haxeko/h2-zigbee-lis2dh12/hardware/out/fab/activity-badge-bom-jlcpcb.csv

Comment | Designator | Footprint | LCSC Part # | Manufacturer Part # | Qty
10 uF 16 V X5R 0603 | C1 | 0603 |  |  | 1
10 uF 10 V X5R 0603 | C2,C5,C8 | 0603 |  |  | 3
1 uF 16 V X5R 0402 | C3 | 0402 |  |  | 1
22 uF 6.3 V X5R 0805 | C4 | 0805 |  |  | 1
100 nF 16 V X7R 0402 | C6,C7,C9,C11 | 0402 |  |  | 4
10 nF 50 V X7R 0402 | C10 | 0402 |  |  | 1
LED green 0603 | D1 | 0603 |  |  | 1
LED orange 0603 | D2 | 0603 |  |  | 1
TYPE-C-31-M-12 | J1 | USB_C_Receptacle_HRO_TYPE-C-31-M-12 |  | TYPE-C-31-M-12 | 1
AO3401A | Q1 | SOT-23 |  | AO3401A | 1
2N7002 | Q2 | SOT-23 |  | 2N7002 | 1
5.1 k 1% 0402 | R1,R2 | 0402 |  |  | 2
4.7 k 1% 0402 | R3,R5,R6 | 0402 |  |  | 3
1 k 1% 0402 | R4 | 0402 |  |  | 1
10 k 1% 0402 | R7,R8 | 0402 |  |  | 2
2.2 k 1% 0402 | R9 | 0402 |  |  | 1
1 M 1% 0402 | R10,R11 | 0402 |  |  | 2
100 k 1% 0402 | R12,R13 | 0402 |  |  | 2
0 R 0402 | R14,R15 | 0402 |  |  | 2
B3U-1000P | SW1,SW2 | SW_SPST_B3U-1000P |  | B3U-1000P | 2
ESP32-H2-WROOM-02C-H4S | U1 | ESP32-H2-WROOM-02C |  | ESP32-H2-WROOM-02C-H4S | 1
LIS2DH12TR | U2 | LGA-12 |  | LIS2DH12TR | 1
RT9080-33GJ5 | U3 | TSOT-23-5 |  | RT9080-33GJ5 | 1
MCP73831T-2ACI/OT | U4 | SOT-23-5 |  | MCP73831T-2ACI/OT | 1
USBLC6-2SC6 | U5 | SOT-23-6 |  | USBLC6-2SC6 | 1
