haxeko/h2-zigbee-lis2dh12/hardware/out/activity-badge.pdf

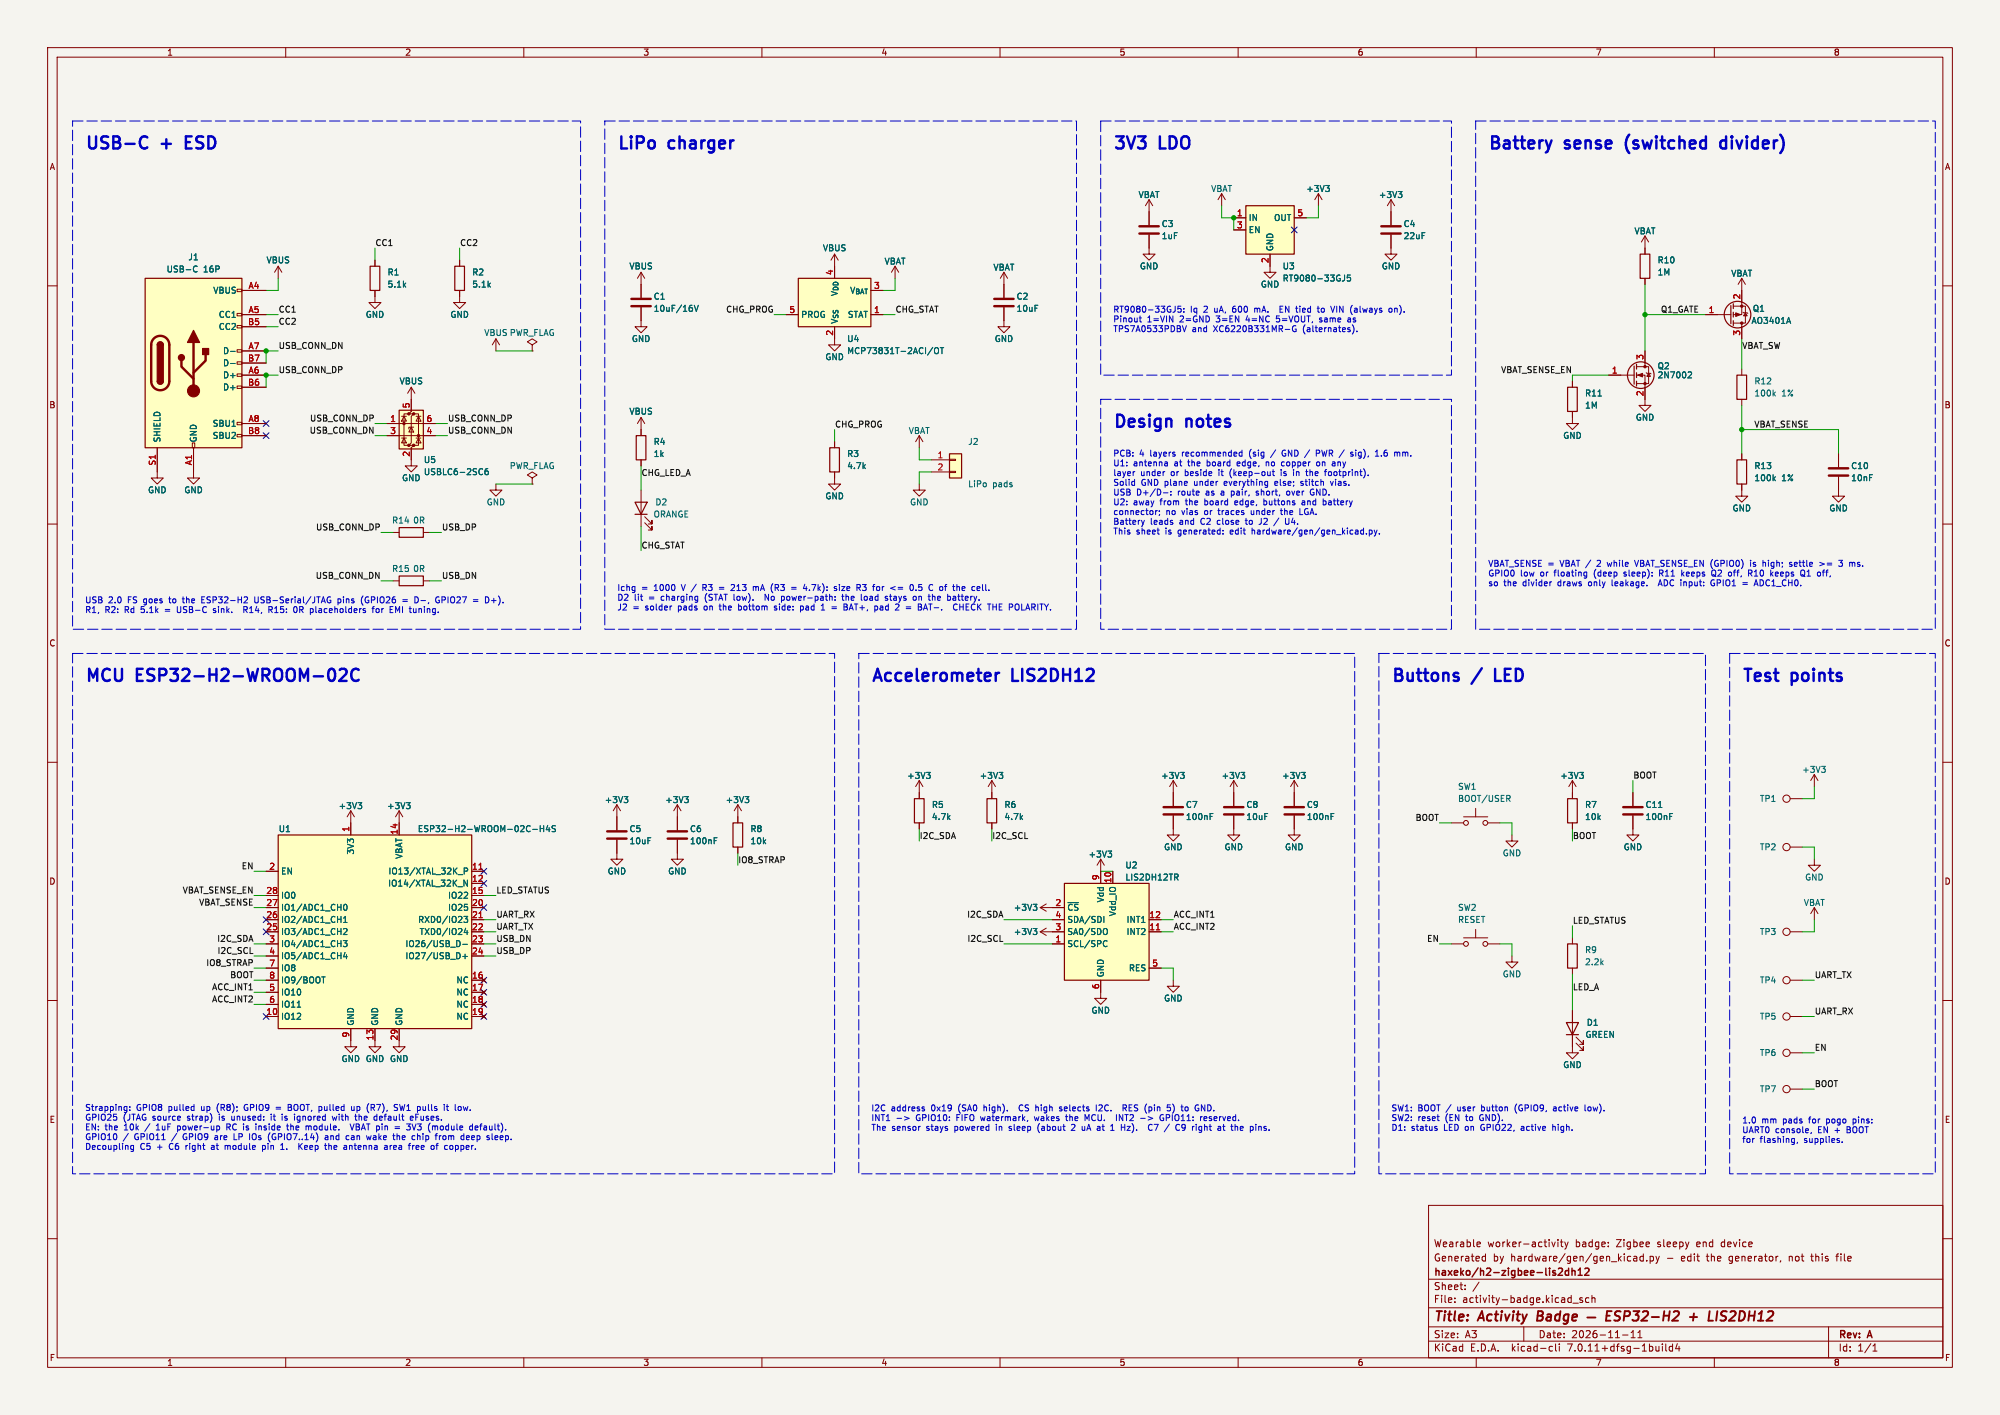
[picture p3: page 1]

VBAT VBAT GND GND

LiPo pads VBAT GND

SW1: BOOT / user button (GPIO9, active low). SW2: reset (EN to GND). D1: status LED on GPIO22, active high.
