haxeko/h2-zigbee-lis2dh12/hardware/out/pcb-back.pdf

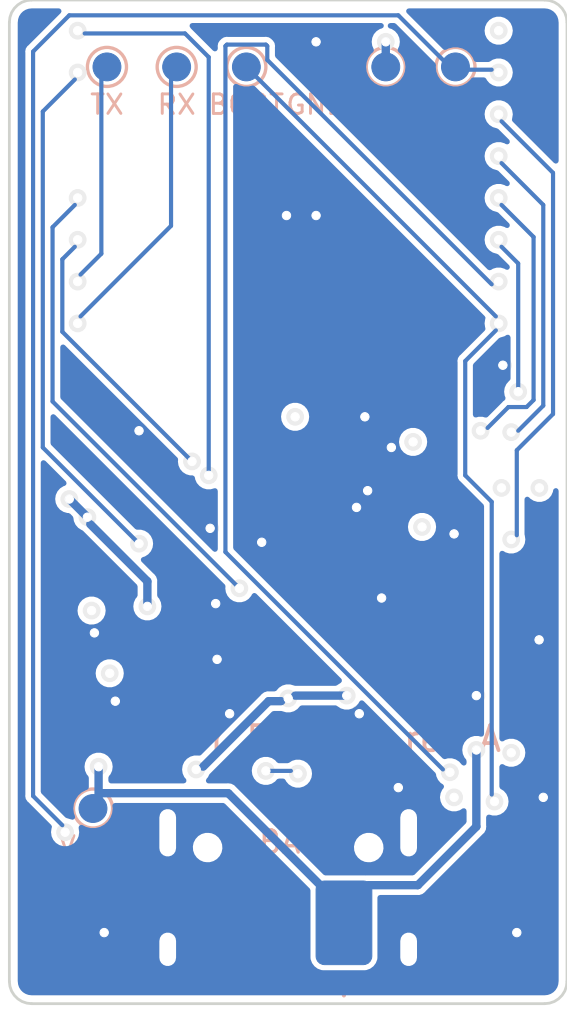
[picture p4: page 1]
