haxeko/h2-zigbee-lis2dh12/hardware/out/pcb-front.pdf

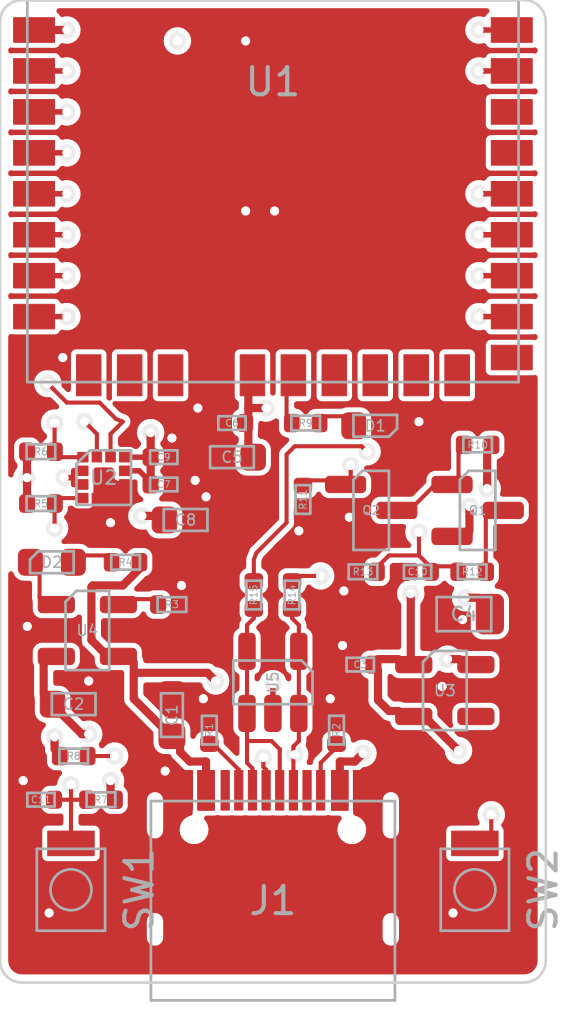
[picture p5: page 1]
