haxeko/h2-zigbee-lis2dh12/hardware/kicad/activity-badge.kicad_pcb

## KiCad design hardware/kicad/activity-badge.kicad_pcb (2026-11-11)

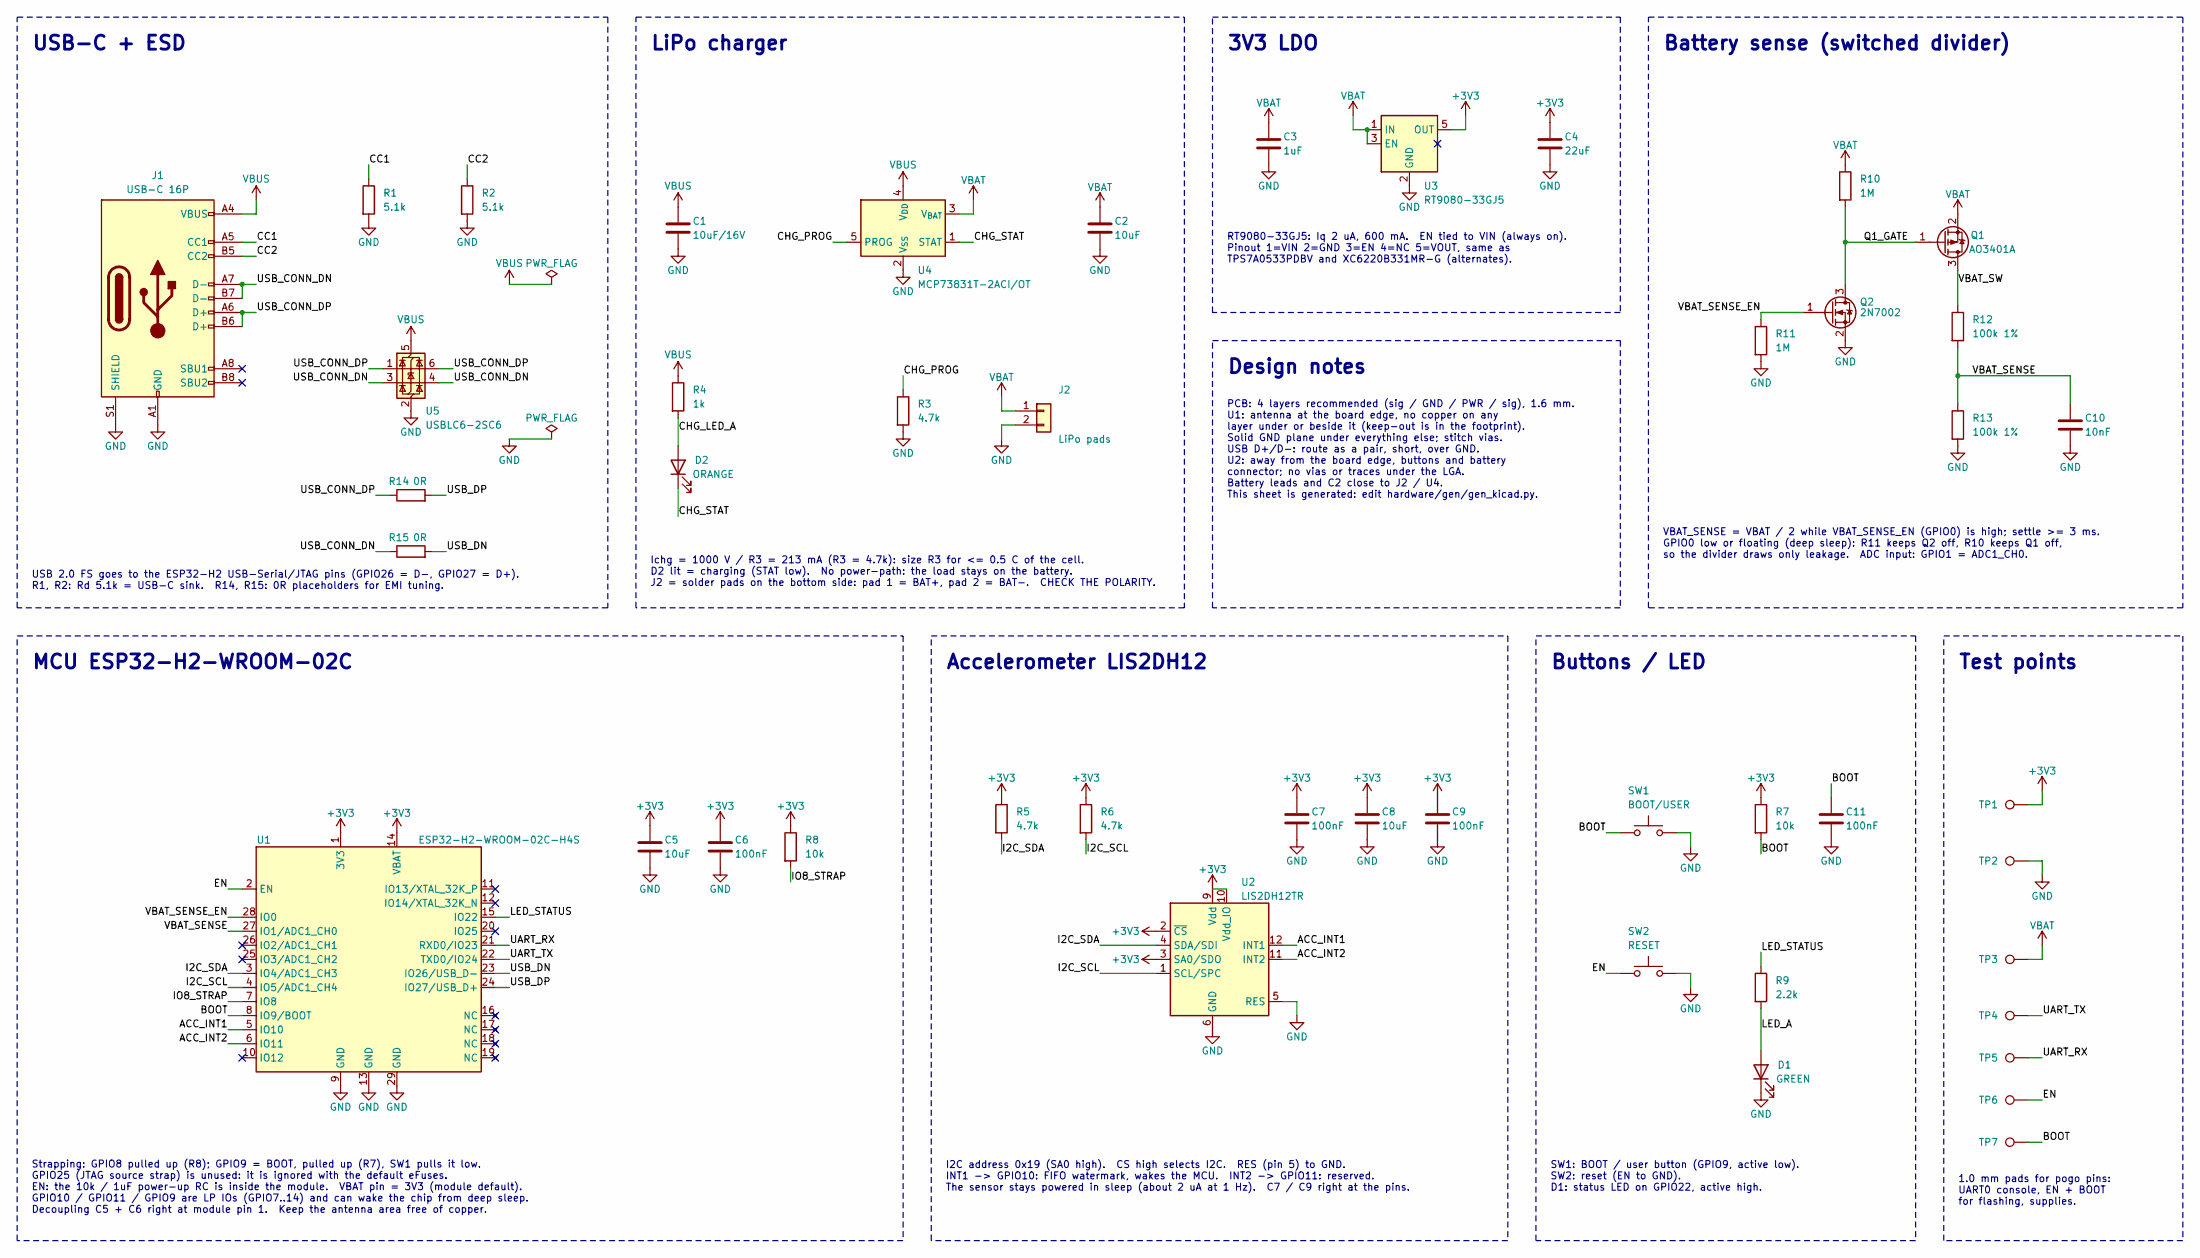
[picture p6: schematic activity-badge.kicad_sch, Activity Badge — ESP32-H2 + LIS2DH12]

Parts:
C1: 10uF/16V; C_0603_1608Metric; MPN CL10A106KO8NNNC
C2, C5, C8: 10uF; C_0603_1608Metric; MPN CL10A106KP8NNNC
C3: 1uF; C_0402_1005Metric; MPN CL05A105KO5NNNC
C4: 22uF; C_0805_2012Metric; MPN CL21A226MQQNNNE
C6, C7, C9, C11: 100nF; C_0402_1005Metric; MPN CL05B104KO5NNNC
C10: 10nF; C_0402_1005Metric; MPN CL05B103KB5NNNC
D1: GREEN; LED_0603_1608Metric; MPN LTST-C191KGKT
D2: ORANGE; LED_0603_1608Metric; MPN LTST-C191KFKT
J1: USB-C 16P; USB_C_Receptacle_HRO_TYPE-C-31-M-12; MPN TYPE-C-31-M-12
J2: LiPo pads; BatteryPads_1x02_P4.0mm
Q1: AO3401A; SOT-23; MPN AO3401A
Q2: 2N7002; SOT-23; MPN 2N7002
R1, R2: 5.1k; R_0402_1005Metric; MPN RC0402FR-075K1L
R3, R5, R6: 4.7k; R_0402_1005Metric; MPN RC0402FR-074K7L
R4: 1k; R_0402_1005Metric; MPN RC0402FR-071KL
R7, R8: 10k; R_0402_1005Metric; MPN RC0402FR-0710KL
R9: 2.2k; R_0402_1005Metric; MPN RC0402FR-072K2L
R10, R11: 1M; R_0402_1005Metric; MPN RC0402FR-071ML
R12, R13: 100k 1%; R_0402_1005Metric; MPN RC0402FR-07100KL
R14, R15: 0R; R_0402_1005Metric; MPN RC0402JR-070RL
SW1: BOOT/USER; SW_SPST_B3U-1000P; MPN B3U-1000P
SW2: RESET; SW_SPST_B3U-1000P; MPN B3U-1000P
TP1: +3V3; TestPoint_Pad_D1.0mm
TP2: GND; TestPoint_Pad_D1.0mm
TP3: VBAT; TestPoint_Pad_D1.0mm
TP4: UART_TX; TestPoint_Pad_D1.0mm
TP5: UART_RX; TestPoint_Pad_D1.0mm
TP6: EN; TestPoint_Pad_D1.0mm
TP7: BOOT; TestPoint_Pad_D1.0mm
U1: ESP32-H2-WROOM-02C-H4S; ESP32-H2-WROOM-02C; MPN ESP32-H2-WROOM-02C-H4S
U2: LIS2DH12TR; LGA-12_2x2mm_P0.5mm; MPN LIS2DH12TR
U3: RT9080-33GJ5; TSOT-23-5; MPN RT9080-33GJ5
U4: MCP73831T-2ACI/OT; SOT-23-5; MPN MCP73831T-2ACI/OT
U5: USBLC6-2SC6; SOT-23-6; MPN USBLC6-2SC6

Connections:
+3V3: C4.1, C5.1, C6.1, C7.1, C8.1, C9.1, R5.1, R6.1, R7.1, R8.1, TP1.1, U1.1 (3V3), U1.14 (VBAT), U2.2 (~CS), U2.3 (SA0/SDO), U2.9 (Vdd), U2.10 (Vdd_IO), U3.5 (OUT)
/ACC_INT1: U1.5 (IO10), U2.12 (INT1)
/ACC_INT2: U1.6 (IO11), U2.11 (INT2)
/BOOT: C11.1, R7.2, SW1.1, TP7.1, U1.8 (IO9/BOOT)
/CC1: J1.A5 (CC1), R1.1
/CC2: J1.B5 (CC2), R2.1
/CHG_LED_A: D2.2 (A), R4.2
/CHG_PROG: R3.1, U4.5 (PROG)
/CHG_STAT: D2.1 (K), U4.1 (STAT)
/EN: SW2.1, TP6.1, U1.2 (EN)
/I2C_SCL: R6.2, U1.4 (IO5/ADC1_CH4), U2.1 (SCL/SPC)
/I2C_SDA: R5.2, U1.3 (IO4/ADC1_CH3), U2.4 (SDA/SDI)
/IO8_STRAP: R8.2, U1.7 (IO8)
/LED_A: D1.2 (A), R9.2
/LED_STATUS: R9.1, U1.15 (IO22)
/Q1_GATE: Q1.1 (G), Q2.3 (D), R10.2
/UART_RX: TP5.1, U1.21 (RXD0/IO23)
/UART_TX: TP4.1, U1.22 (TXD0/IO24)
/USB_CONN_DN: J1.A7 (D-), J1.B7 (D-), R15.1, U5.3 (I/O2), U5.4 (I/O2)
/USB_CONN_DP: J1.A6 (D+), J1.B6 (D+), R14.1, U5.1 (I/O1), U5.6 (I/O1)
/USB_DN: R15.2, U1.23 (IO26/USB_D-)
/USB_DP: R14.2, U1.24 (IO27/USB_D+)
/VBAT_SENSE: C10.1, R12.2, R13.1, U1.27 (IO1/ADC1_CH0)
/VBAT_SENSE_EN: Q2.1 (G), R11.1, U1.28 (IO0)
/VBAT_SW: Q1.3 (D), R12.1
GND: C1.2, C2.2, C3.2, C4.2, C5.2, C6.2, C7.2, C8.2, C9.2, C10.2, C11.2, D1.1 (K), J1.A1 (GND), J1.A12 (GND), J1.B1 (GND), J1.B12 (GND), J1.S1 (SHIELD), J2.2, Q2.2 (S), R1.2, R2.2, R3.2, R11.2, R13.2, SW1.2, SW2.2, TP2.1, U1.9 (GND), U1.13 (GND), U1.29 (GND), U2.5 (RES), U2.6 (GND), U2.7 (GND), U2.8 (GND), U3.2 (GND), U4.2 (V_{SS}), U5.2 (GND)
VBAT: C2.1, C3.1, J2.1, Q1.2 (S), R10.1, TP3.1, U3.1 (IN), U3.3 (EN), U4.3 (V_{BAT})
VBUS: C1.1, J1.A4 (VBUS), J1.A9 (VBUS), J1.B4 (VBUS), J1.B9 (VBUS), R4.1, U4.4 (V_{DD}), U5.5 (VBUS)

Notes on the sheet:
USB-C + ESD
USB 2.0 FS goes to the ESP32-H2 USB-Serial/JTAG pins (GPIO26 = D-, GPIO27 = D+). R1, R2: Rd 5.1k = USB-C sink. R14, R15: 0R placeholders for EMI tuning.
LiPo charger
Ichg = 1000 V / R3 = 213 mA (R3 = 4.7k): size R3 for <= 0.5 C of the cell. D2 lit = charging (STAT low). No power-path: the load stays on the battery. J2 = solder pads on the bottom side: pad 1 = BAT+, pad 2 = BAT-. CHECK THE POLARITY.
3V3 LDO
RT9080-33GJ5: Iq 2 uA, 600 mA. EN tied to VIN (always on). Pinout 1=VIN 2=GND 3=EN 4=NC 5=VOUT, same as TPS7A0533PDBV and XC6220B331MR-G (alternates).
Design notes
PCB: 4 layers recommended (sig / GND / PWR / sig), 1.6 mm. U1: antenna at the board edge, no copper on any layer under or beside it (keep-out is in the footprint). Solid GND plane under everything else; stitch vias. USB D+/D-: route as a pair, short, over GND. U2: away from the board edge, buttons 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
Battery sense (switched divider)
VBAT_SENSE = VBAT / 2 while VBAT_SENSE_EN (GPIO0) is high; settle >= 3 ms. GPIO0 low or floating (deep sleep): R11 keeps Q2 off, R10 keeps Q1 off, so the divider draws only leakage. ADC input: GPIO1 = ADC1_CH0.
MCU ESP32-H2-WROOM-02C
Strapping: GPIO8 pulled up (R8); GPIO9 = BOOT, pulled up (R7), SW1 pulls it low. GPIO25 (JTAG source strap) is unused: it is ignored with the default eFuses. EN: the 10k / 1uF power-up RC is inside the module. VBAT pin = 3V3 (module default). GPIO10 / GPIO11 / GPIO9 are LP IOs (GPIO7..14) and can w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
Accelerometer LIS2DH12
I2C address 0x19 (SA0 high). CS high selects I2C. RES (pin 5) to GND. INT1 -> GPIO10: FIFO watermark, wakes the MCU. INT2 -> GPIO11: reserved. The sensor stays powered in sleep (about 2 uA at 1 Hz). C7 / C9 right at the pins.
Buttons / LED
SW1: BOOT / user button (GPIO9, active low). SW2: reset (EN to GND). D1: status LED on GPIO22, active high.
Test points
1.0 mm pads for pogo pins: UART0 console, EN + BOOT for flashing, supplies.

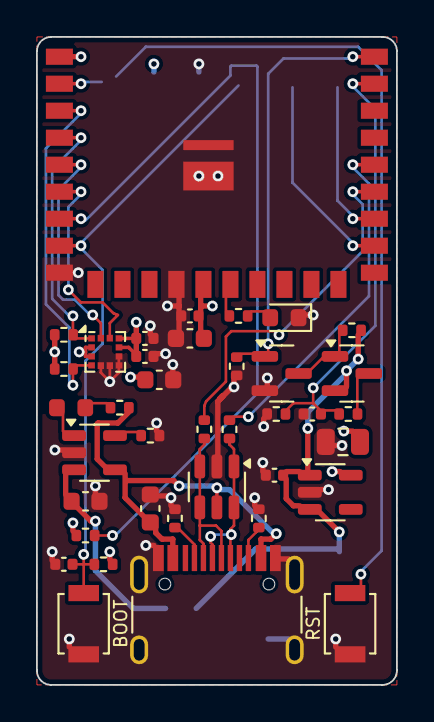
[picture p7: board activity-badge.kicad_pcb from above]

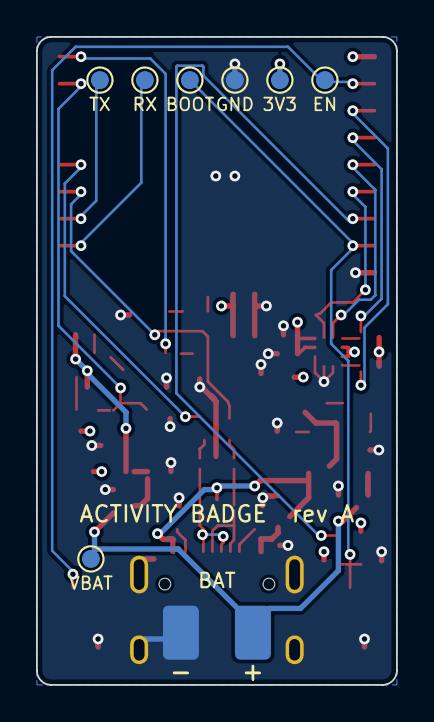
[picture p8: board activity-badge.kicad_pcb from below]

Board: 4 copper layers, 20.0 x 36.0 mm, 46 parts (8 on the bottom side), 28 nets.
