haxeko/h2-zigbee-lis2dh12/(commit log)

2026-11-11 Add activity badge design: hardware, firmware and Zigbee2MQTT converter
    Wearable badge that reports a worker's activity level once a minute:
    ESP32-H2-WROOM-02C + LIS2DH12, Zigbee sleepy end device, LiPo powered.
    hardware/
    - KiCad project generated from one parts/nets description
    (gen/gen_kicad.py), with a custom symbol and footprint for the
    ESP32-H2-WROOM-02C, schematic PDF, netlist and BOM. The generator
    checks the netlist exported by kicad-cli against the intended one.
    - README with pin map, BOM, footprints and PCB layout notes.
    firmware/ (ESP-IDF v5.5.4, esp-zigbee-lib 2.1.0)
    - LIS2DH12 samples at 1 Hz in low-power mode into its FIFO; the MCU
    wakes on the watermark interrupt, ac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
    [activity-badge.kicad_sch, bom.csv, partitions.csv]
2026-11-11 Add routed 4-layer PCB (20 x 36 mm) with USB-C charging port
    The board is laid out with KiCad's pcbnew API by hardware/gen/gen_pcb.py:
    placement table, hand-drawn escapes for the 0.5 mm pitch parts (USB-C
    connector, LIS2DH12), module decoupling and a via next to every module
    pad, and a small grid maze router (router.py) for everything else.
    - 20 x 36 mm, 4 layers: parts and signals on top, unbroken GND plane,
    +3V3 plane, signals on the bottom. All 38 parts are on the top side;
    the module antenna overhangs the top edge.
    - For compactness the battery connector became solder pads on the
    bottom side, the tactile switches are Omron B3U and the test pads
    moved to the bottom.
    - Design rule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
    [activity-badge-B_Cu.gbl, activity-badge-B_Mask.gbs, activity-badge-B_Paste.gbp, activity-badge-B_Silkscreen.gbo, activity-badge-Edge_Cuts.gm1, activity-badge-F_Cu.gtl, activity-badge-F_Mask.gts, activity-badge-F_Paste.gtp]
2026-11-11 Use 0.3 mm via holes (0.6 mm vias) on the PCB
    All vias are now 0.6 mm with a 0.3 mm hole (0.15 mm annular ring), the
    smallest hole on the board, so the design fits standard fabrication
    without small-drill surcharges.
    - Design rules in the project file: min via 0.6 mm, min hole 0.3 mm.
    - USB-C escape redrawn so the larger D+ via fits between the 0.5 mm
    pitch pads: the outer D- trace steps aside early and CC1 leaves its
    pad at 45 degrees.
    - gen_pcb.py gained a clean-up step: hand-placed vias the router did
    not need are removed with KiCad's connectivity test, keeping
    junctions connected (a one-layer via becomes short track links, a
    dangling track that others branch off from is only s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
    [activity-badge-B_Cu.gbl, activity-badge-B_Mask.gbs, activity-badge-B_Paste.gbp, activity-badge-B_Silkscreen.gbo, activity-badge-Edge_Cuts.gm1, activity-badge-F_Cu.gtl, activity-badge-F_Mask.gts, activity-badge-F_Paste.gtp]
2026-11-11 Clarify that the board is powered through the charger when flashing over USB
    Claude-Session: https://claude.ai/code/session_01TvrXHTKGfyiyNejePT8mYw
2026-11-11 Add JLCPCB-format BOM and CPL to the fabrication outputs
    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
    [activity-badge-B_Cu.gbl, activity-badge-B_Mask.gbs, activity-badge-B_Paste.gbp, activity-badge-B_Silkscreen.gbo, activity-badge-Edge_Cuts.gm1, activity-badge-F_Cu.gtl, activity-badge-F_Mask.gts, activity-badge-F_Paste.gtp]
